wads1234k/Auto-Handwrap-Roller/3d_ part/Shaft.stl

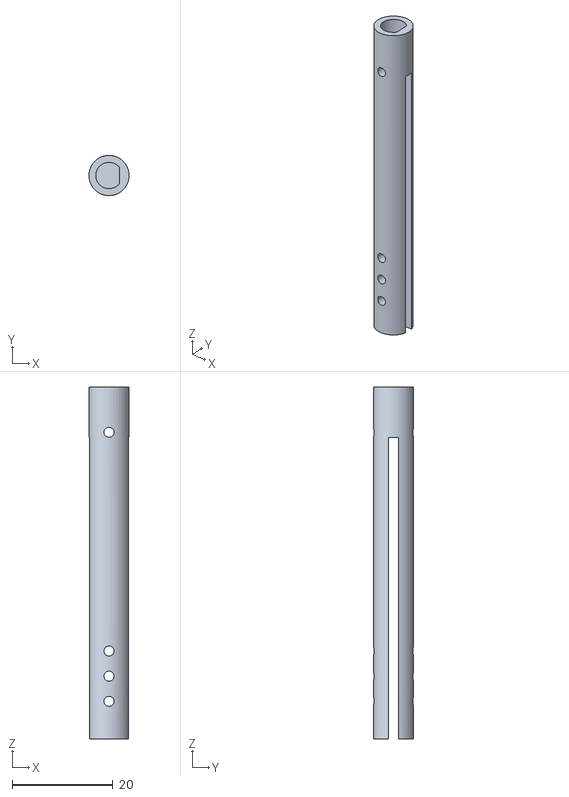
[picture p7: CAD file, 2026-01-22]
3d_ part/Shaft.stl
8.00 x 8.00 x 70.0
