wads1234k/Auto-Handwrap-Roller/3d_ part/Cover.stl

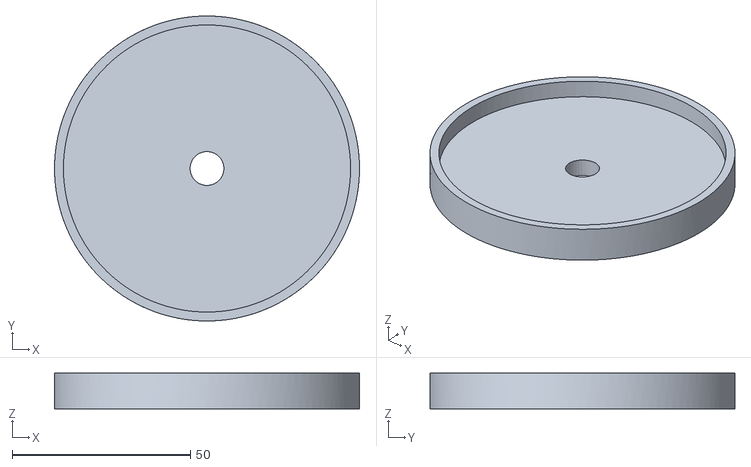
[picture p8: CAD file, 2026-01-22]
3d_ part/Cover.stl
85.5 x 85.5 x 10.0
