wads1234k/Auto-Handwrap-Roller/3d_ part/Body.stl

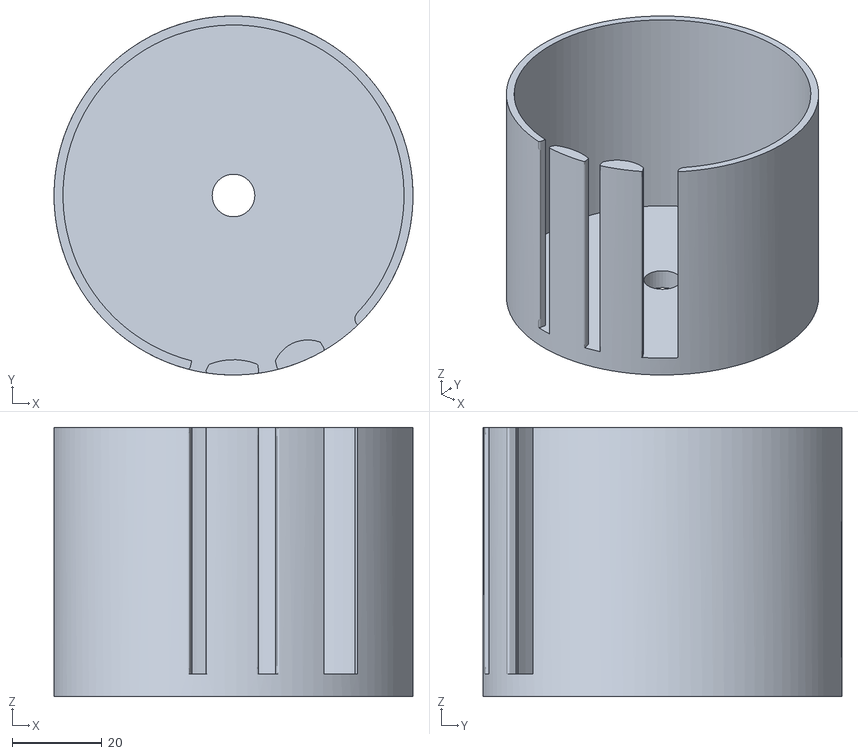
[picture p9: CAD file, 2026-01-22]
3d_ part/Body.stl
80.0 x 80.0 x 60.0
